tgnhrkn/remote-stepper/blog/3_16_22.md

# 3/16/2022

Many things have happened with this project:
1. Attempted to solder everything onto a protoboard: failed (and killed an ESP32 and voltage regulator)
2. Drew up circuit, symbols, footprints, pcb in Kicad and ordered them: semi-failed (through hole pads too narrow)
