tgnhrkn/remote-stepper/circuit/remote_stepper/remote_stepper/remote_stepper.kicad_pcb

## KiCad design circuit/remote_stepper/remote_stepper/remote_stepper.kicad_pcb (2022-03-17)

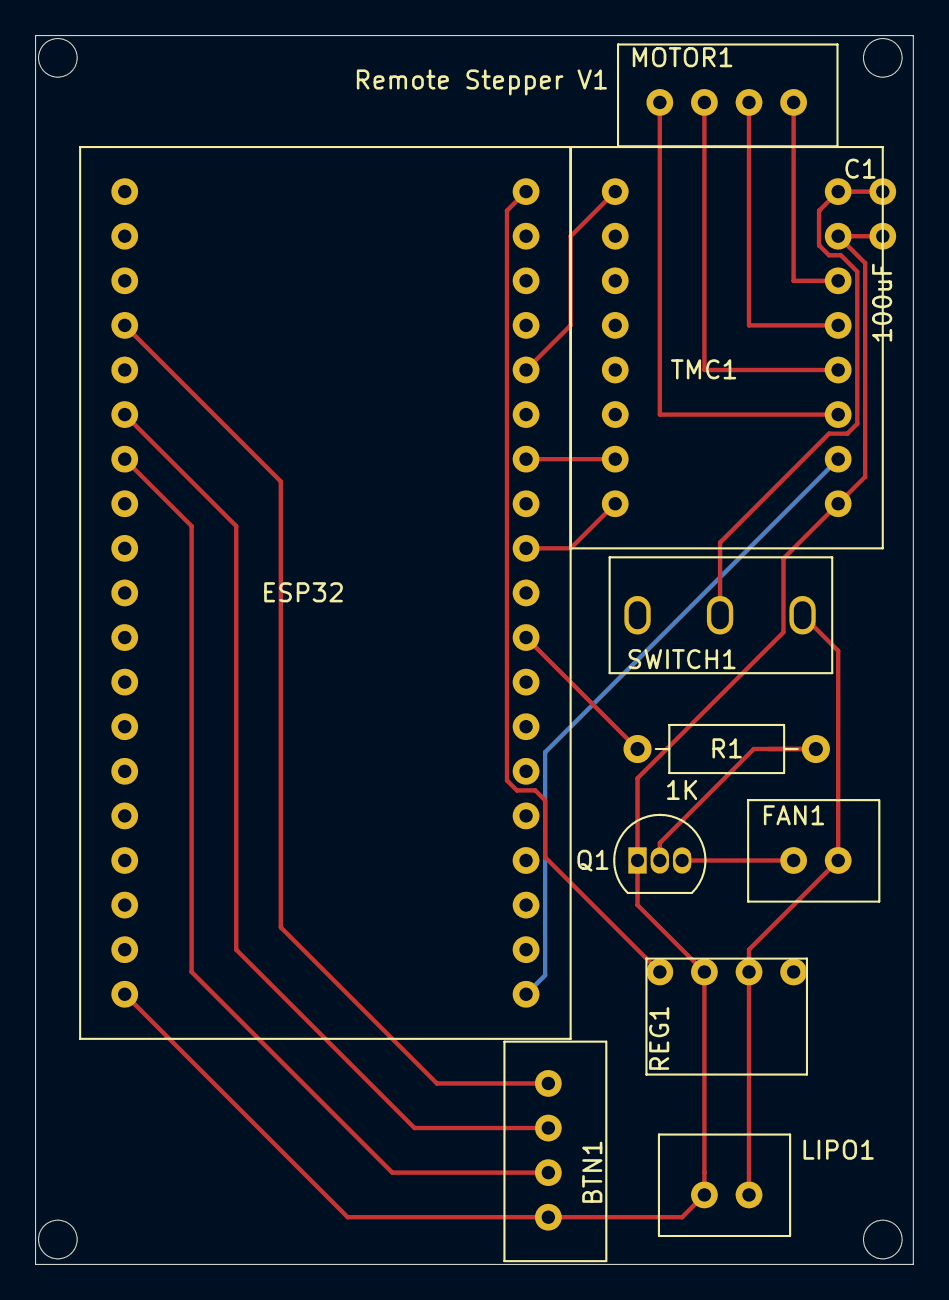
[picture p1: board remote_stepper.kicad_pcb from above]

Board: 2 copper layers, 50.0 x 70.0 mm, 11 parts (0 on the bottom side), 18 nets.

Parts:
BTN1: button_connector; XH-4A
C1: 100uF; XH-2A
ESP32: teylen_esp_wroom_32; 38pin_2.54mm_pitch_10wide
FAN1: fan_connector; XH-2A
LIPO1: 14.8V Battery; XH-2A
MOTOR1: motor_connector; XH-4A
Q1: PN2222A; TO-92_Inline
R1: 1K; R_Axial_DIN0207_L6.3mm_D2.5mm_P10.16mm_Horizontal
REG1: regulator_100; regulator
SWITCH1: switch
TMC1: TMC2208; tmc2208

Connections:
+3V3: ESP32.20, TMC1.10
+5V: ESP32.38, REG1.1
+BATT: FAN1.1, LIPO1.1, REG1.3, SWITCH1.3
GND: BTN1.1, C1.2, ESP32.19, LIPO1.2, Q1.1, REG1.2, TMC1.9, TMC1.15
unnamed: BTN1.2, ESP32.7
unnamed: BTN1.3, ESP32.6
unnamed: BTN1.4, ESP32.4
unnamed: C1.1, SWITCH1.2, TMC1.16
unnamed: ESP32.28, R1.1
unnamed: ESP32.30, TMC1.8
unnamed: ESP32.32, TMC1.7
unnamed: ESP32.34, TMC1.1
unnamed: FAN1.2, Q1.3
unnamed: MOTOR1.1, TMC1.14
unnamed: MOTOR1.2, TMC1.13
unnamed: MOTOR1.3, TMC1.12
unnamed: MOTOR1.4, TMC1.11
unnamed: Q1.2, R1.2
